cactode/k_type/PCB/K-Type PCBA BOM.xlsx

# | Qty | Part Reference | Part Number | MFGR | Description | Footprint | Notes
1 | 12 | C5,C8,C11,C20,C23,C12,C2,C6,C9,C16,C18,C21 | EMK105B7104KV-F | Taiyo Yuden | Multilayer Ceramic Capacitors MLCC - SMD/SMT .1uF 16Volts X7R +/-10% 0402 STD | SMD-0402
2 | 8 | C1,C3,C7,C10,C15,C17,C19,C22 | JMK105BJ474KV-F | Taiyo Yuden | Multilayer Ceramic Capacitors MLCC - SMD/SMT 0.47uF 6.3V X5R +/-10% 0402 Gen Purp | SMD-0402
3 | 1 | C4 | EEF-CX1D220R | Panasonic | Aluminum Organic Polymer Capacitors 22uF 20volt SP-Cap AEC-Q200 | SMD-7343-Pol | EEF-CS1D220R, EEF-CS1C220R (in that order) may be substituted.
4 | 2 | C14,C13 | JMK105C6225MV-F | Taiyo Yuden | Multilayer Ceramic Capacitors MLCC - SMD/SMT 2.2uF 6.3Volts X6S +/-20% 0402 STD | SMD-0402
5 | 87 | D1..D87 | 1N4148X-TP | MCC | Diodes - General Purpose, Power, Switching 150mA 75V | SOD-523
6 | 2 | J2,J1 | DX07B024XJ1R1300 | JAE Electronics | USB Connectors HYBRID SMT/THRU-HOLE MID MNT - USB TYPE C | USB_C_MIDMOUNT_TH_IMPCUT
7 | 87 | LED1..LED87 | KAILH-PG1280-SMT-LED | Kaihua or Hanhua | RGB LED - Reverse Mount | LED_RGB_3.2x2.8_REVMOUNT | This line item should be placed on the back, with the LED facing the FRONT. Common anode is marked on silk screen with 'A'.
8 | 32 | LED88..LED119 | KAILH-PG1280-SMT-LED | Kaihua or Hanhua | RGB LED - Reverse Mount | LED_RGB_3.2x2.8_REVMOUNT_BACKWARDS | This line item should be placed on the back, with the LED facing the BACK. Common anode is marked on silk screen with 'A'.
9 | 1 | LED120 | LO Q976-PS-25 | Osram | Standard LEDs - SMD Orange, 605nm 280mcd, 20mA | LED-0603
10 | 2 | R9,R17 | RK73B1ETTP133J | KOA Speer | Thick Film Resistors - SMD 1/16watts 13Kohms 5% | SMD-0402
11 | 4 | R8,R11,R7,R10 | RK73B1ETTP512J | KOA Speer | Thick Film Resistors - SMD 1/16watt 5.1Kohms 5% | SMD-0402
12 | 2 | R14,R15 | RK73B1ETTP101J | KOA Speer | Thick Film Resistors - SMD 1/16watts 100ohms 5% | SMD-0402
13 | 2 | R2,R1 | RK73B1ETTP330J | KOA Speer | Thick Film Resistors - SMD 1/16watts 33ohms 5% | SMD-0402
14 | 5 | R3,R4,R12,R13,R16 | RK73B1ETTP102J | KOA Speer | Thick Film Resistors - SMD 1/16watts 1Kohms 5% | SMD-0402
15 | 2 | R5,R6 | RK73B1ETTP104J | KOA Speer | Thick Film Resistors - SMD 1/16watt 100Kohms 5% | SMD-0402
16 | 87 | S1..S87 | CPG151101S11 | Kaihua | Switch Socket - SMD | SW_SOCKET_COMBINED | .pos file does not have coordinates for this component
17 | 1 | S88 | SKQGAKE010 | ALPS | Tactile Switches 50 mAmps at 12 Volts | TACT_5.2x5.2
18 | 1 | U1 | MK20DX256VLH7 | NXP / Freescale | ARM Microcontrollers - MCU KINETIS 256K | LQFP64
19 | 1 | U2 | TS3DS10224RUKR | Texas Instruments | Multiplexer Switch ICs High-Speed 2:4 Diff Mux/Demux | QFN_20_0.4
20 | 1 | U3 | TS3USB30EDGSR | Texas Instruments | USB Switch ICs High-Speed USB 2.0 1:2 Mux/Demux Switch | VSSOP-10
21 | 2 | U4,U5 | IS31FL3733 | ISSI | 12x16 DOTS MATRIX LED DRIVER, QFN-48 | QFN-48-1EP-6mm
22 | 1 | X1 | NX3225SA-16.000M-STD-CSR-1 | NDK | CRYSTAL 16.0000MHZ 8PF SMD | DFN_3.2x2.5 | CX3225GB16000D0HPQCC or NX3225SA-16.000M-STD-CSR-3 can be substituted.
