cactode/k_type/CAD/k-type-assembly.SLDASM

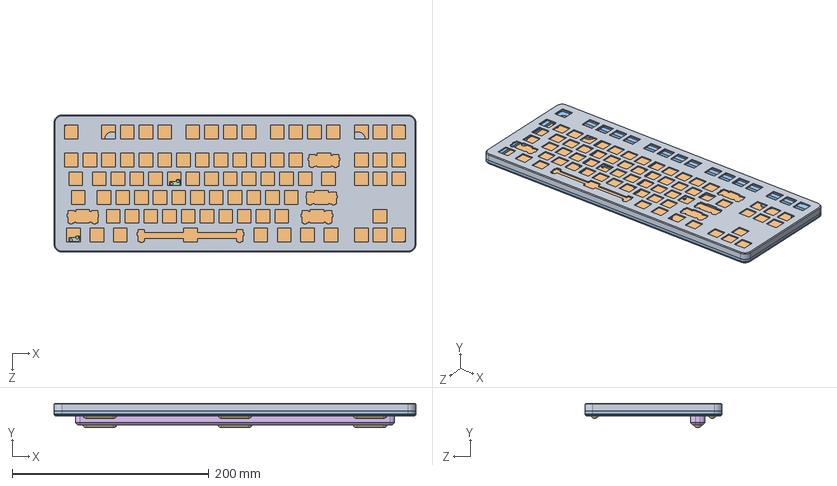
[picture p1: CAD file, 2019-05-21]
CAD/k-type-assembly.SLDASM
368.3 x 24.9 x 139.5 mm
k-type-case-billet
k-type-acrylic-spacer_nothing-special
Kailh-hot-swap-pcb x 2
reverse-mount-led x 2
k-type-bar-foot
pill-rubber-feet x 9
flat-head-shoulder-screw x 8
Metal-Disk-For-Magnetic-Feet x 2
8mm-neodymium-magnet x 2
