cactode/k_type/CAD/k-type-case-.SLDPRT

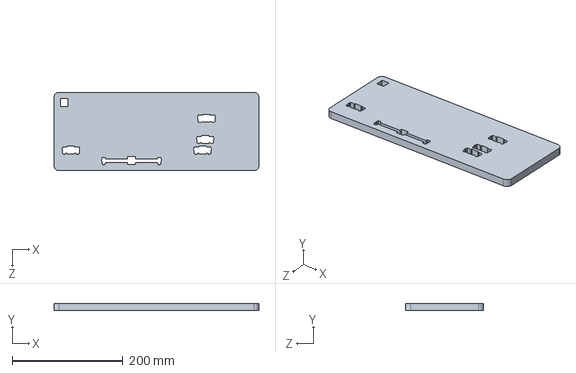
[picture p2: CAD file, 2019-06-02]
CAD/k-type-case-.SLDPRT
370.3 x 12.7 x 141.5 mm
