cactode/k_type/CAM/SACRIFICIAL_BLOCK.DXF

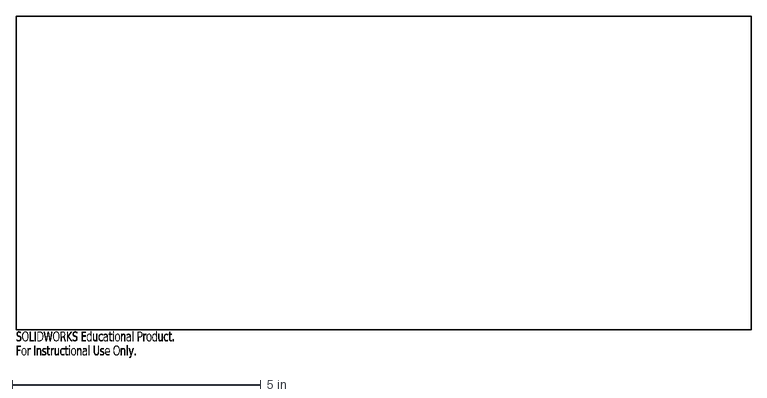
[picture p3: CAD file, 2019-06-02]
CAM/SACRIFICIAL_BLOCK.DXF
SOLIDWORKS Educational Product.
For Instructional Use Only.
