cactode/k_type/CAM/k-type-case-.DXF

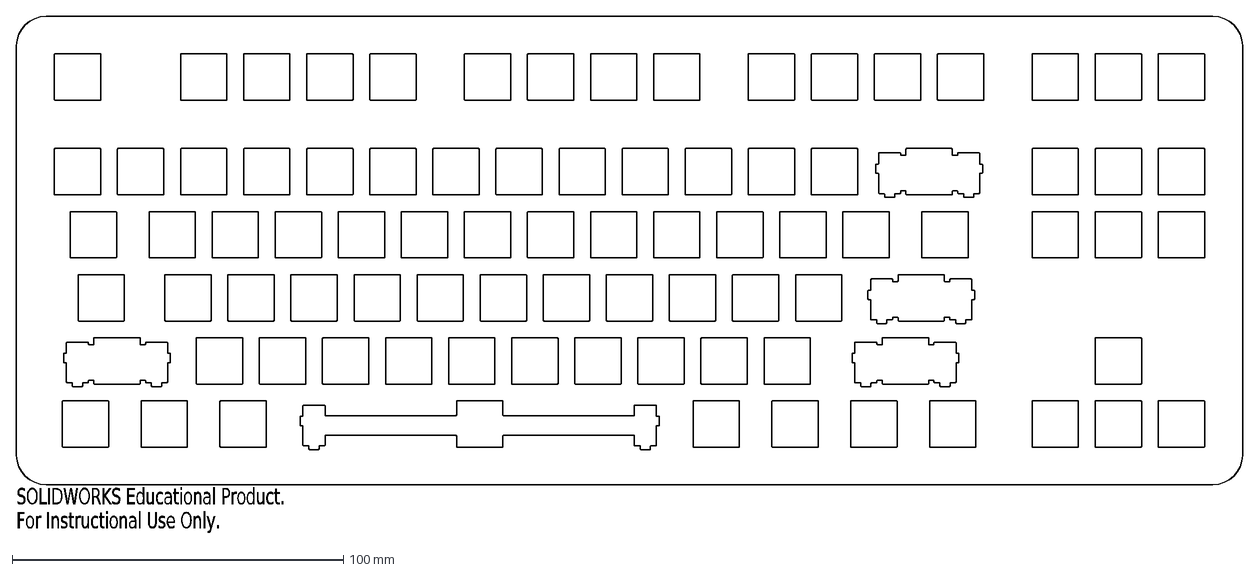
[picture p4: CAD file, 2019-06-02]
CAM/k-type-case-.DXF
SOLIDWORKS Educational Product.
For Instructional Use Only.
