cactode/k_type/CAD/STENCIL_STENCIL.DXF

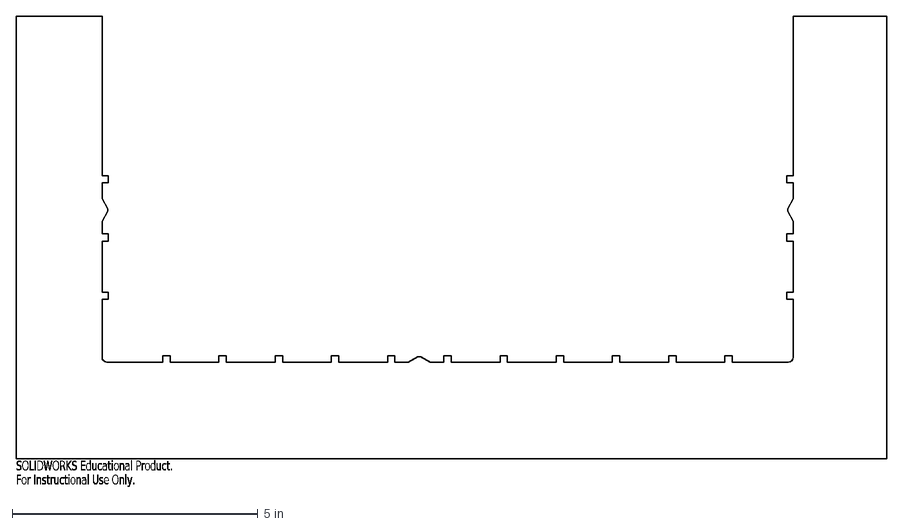
[picture p5: CAD file, 2019-05-21]
CAD/STENCIL_STENCIL.DXF
SOLIDWORKS Educational Product.
For Instructional Use Only.
