cactode/k_type/CAM/k-type-case-new_attempt.DXF

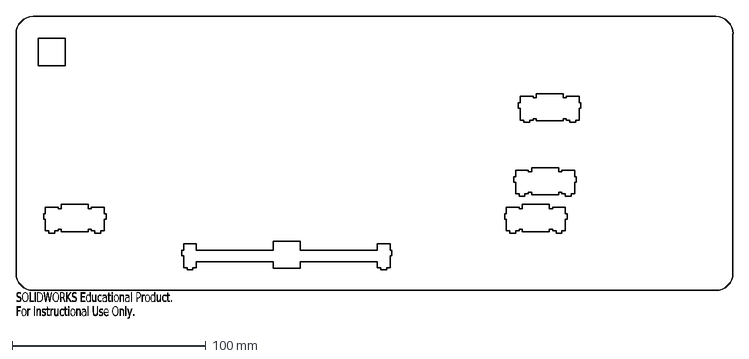
[picture p6: CAD file, 2019-06-02]
CAM/k-type-case-new_attempt.DXF
SOLIDWORKS Educational Product.
For Instructional Use Only.
