cactode/k_type/CAD/ktype-bottom-plate-alt.sldprt

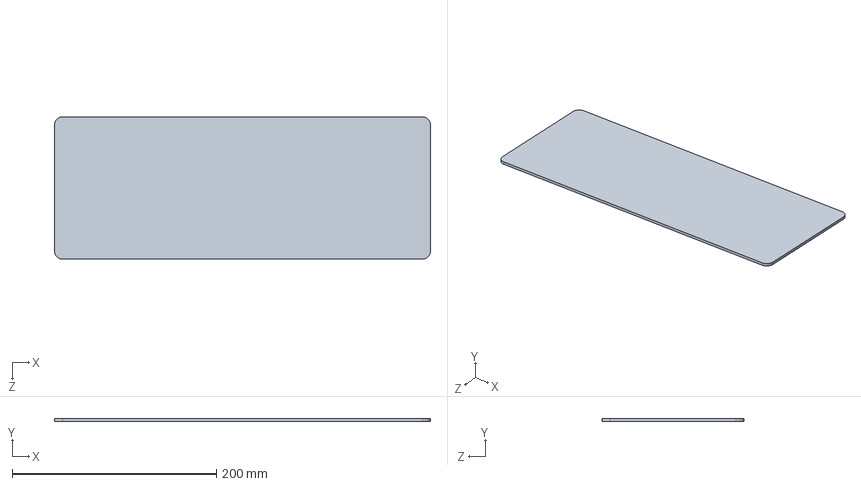
[picture p7: CAD file, 2019-05-21]
CAD/ktype-bottom-plate-alt.sldprt
368.3 x 3.00 x 139.5 mm
