cactode/k_type/CAD/ktype-bottom-plate.sldprt

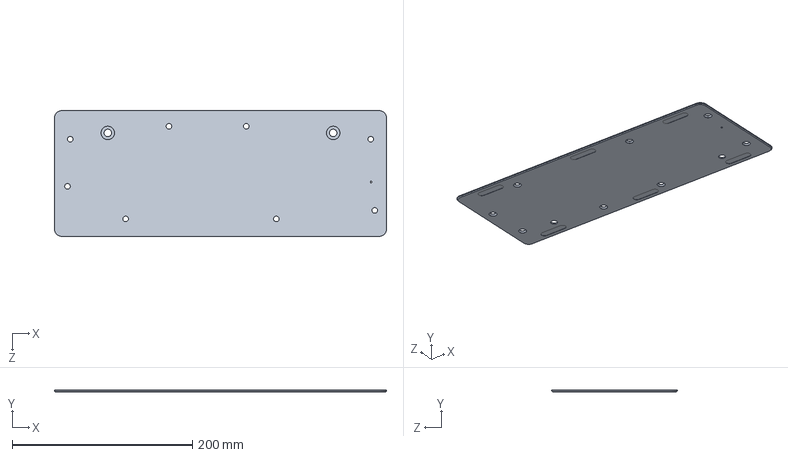
[picture p8: CAD file, 2019-05-21]
CAD/ktype-bottom-plate.sldprt
368.3 x 2.00 x 139.5 mm
