cactode/k_type/CAD/Pcb_1.sldprt

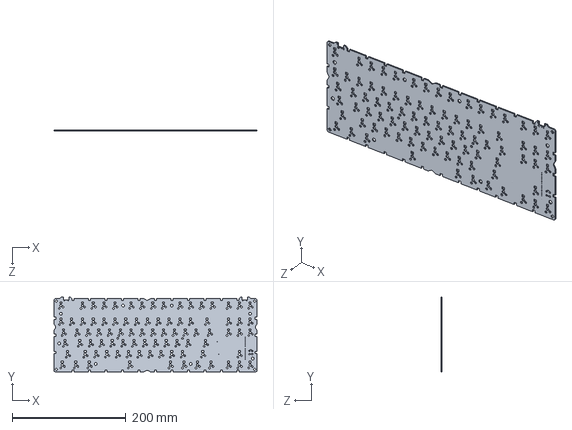
[picture p9: CAD file, 2019-05-21]
CAD/Pcb_1.sldprt
357.5 x 131.8 x 1.60 mm
