cactode/k_type/CAD/flat-head-shoulder-screw.sldprt

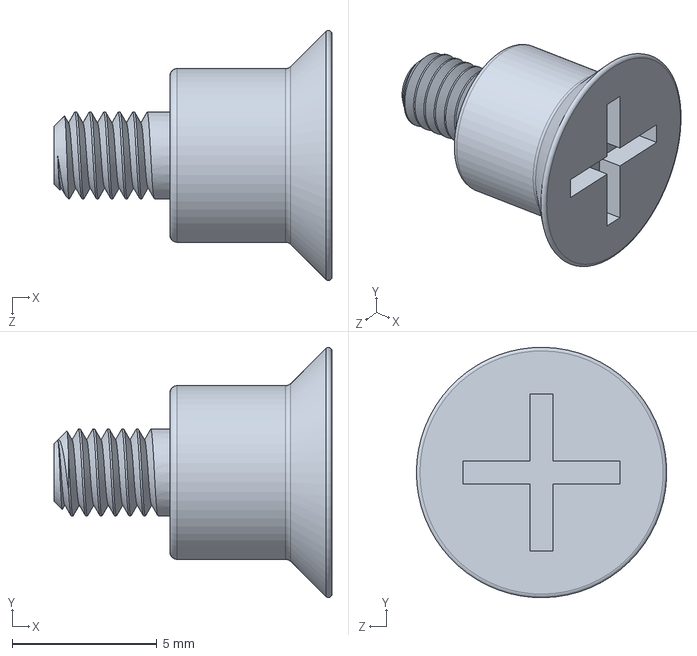
[picture p10: CAD file, 2019-05-21]
CAD/flat-head-shoulder-screw.sldprt
9.60 x 8.64 x 8.64 mm
