cactode/k_type/(list of files, cad)

Other CAD files:
CAD/8mm-neodymium-magnet.sldprt
CAD/Metal-Disk-For-Magnetic-Feet.sldprt
CAD/Kailh-hot-swap-pcb.sldprt
CAD/pill-rubber-feet.sldprt
CAD/k-type-acrylic-spacer_nothing-special.sldprt
CAD/k-type-bar-foot.sldprt
CAD/reverse-mount-led.sldprt
