cactode/k_type/PCB/K-Type.kicad_pcb

## KiCad design PCB/K-Type.kicad_pcb (2019-06-02)

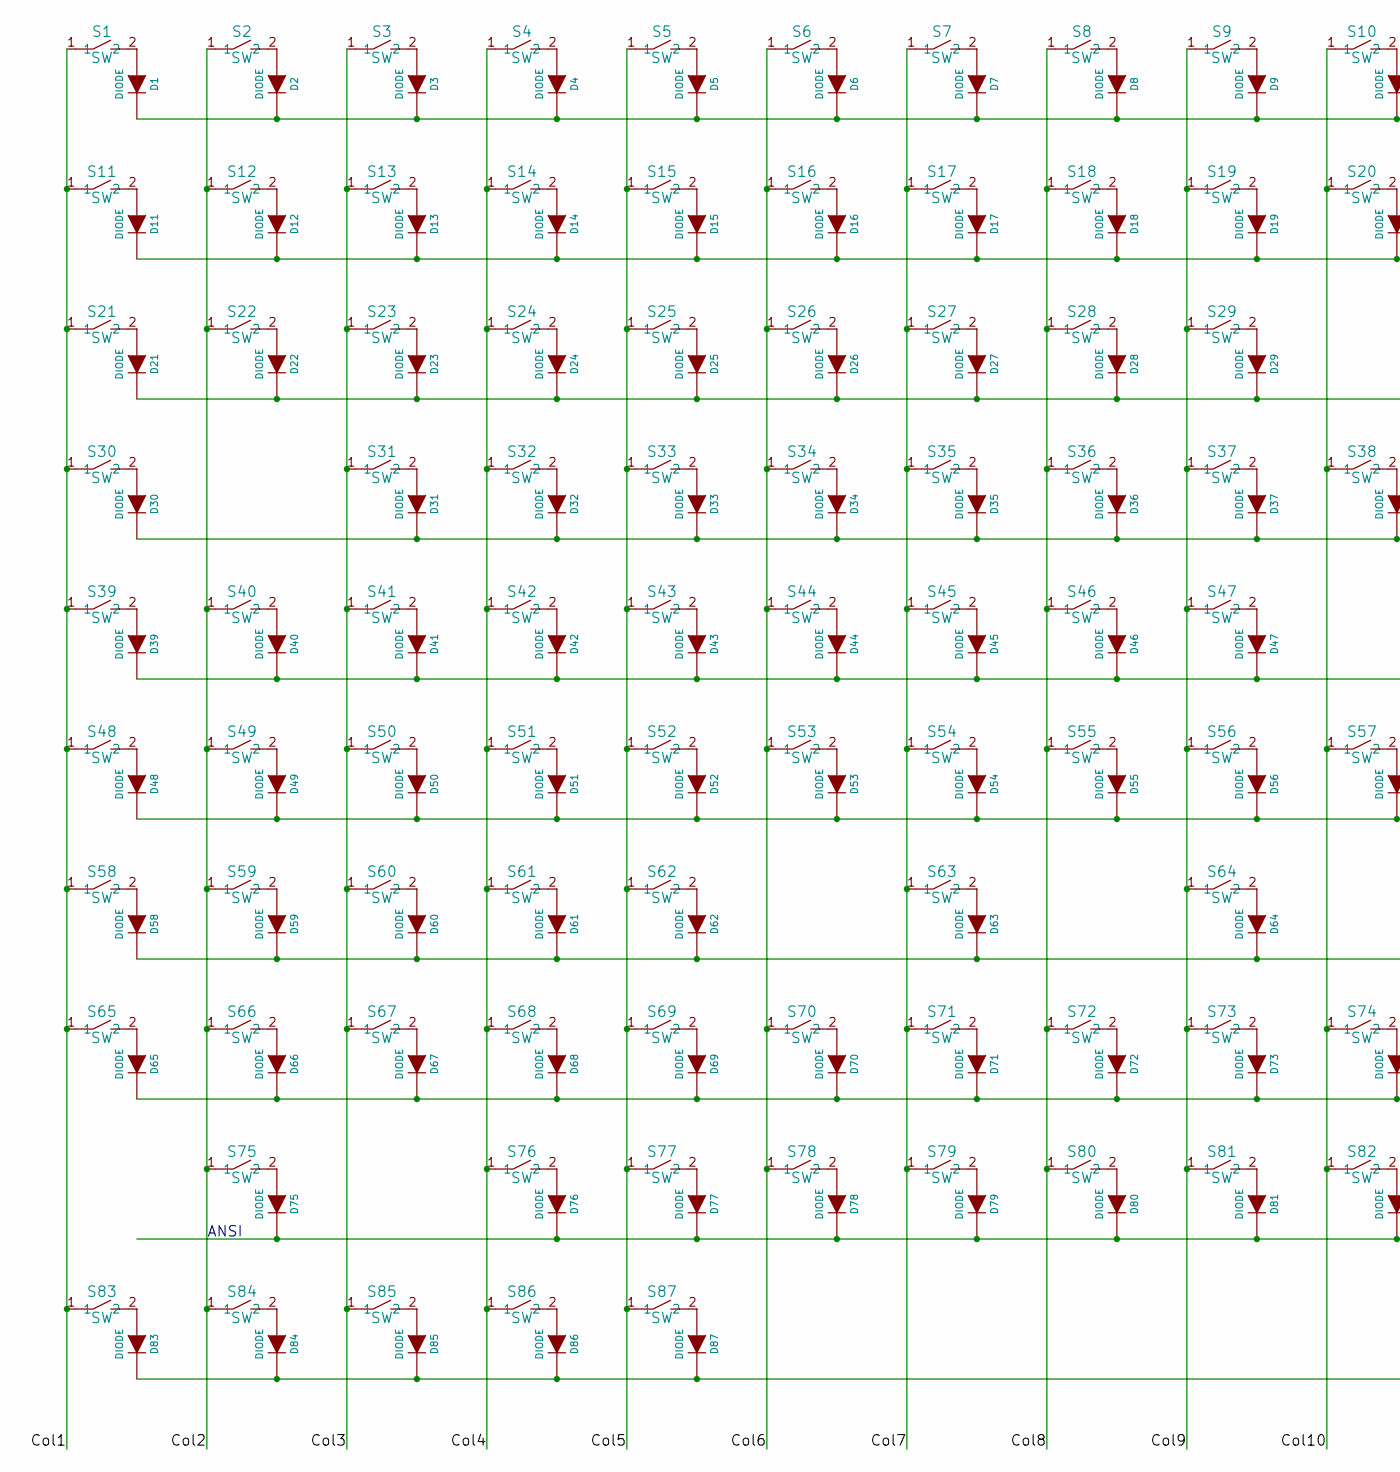
[picture p11: schematic K-Type.sch, part in row 1, column 1]

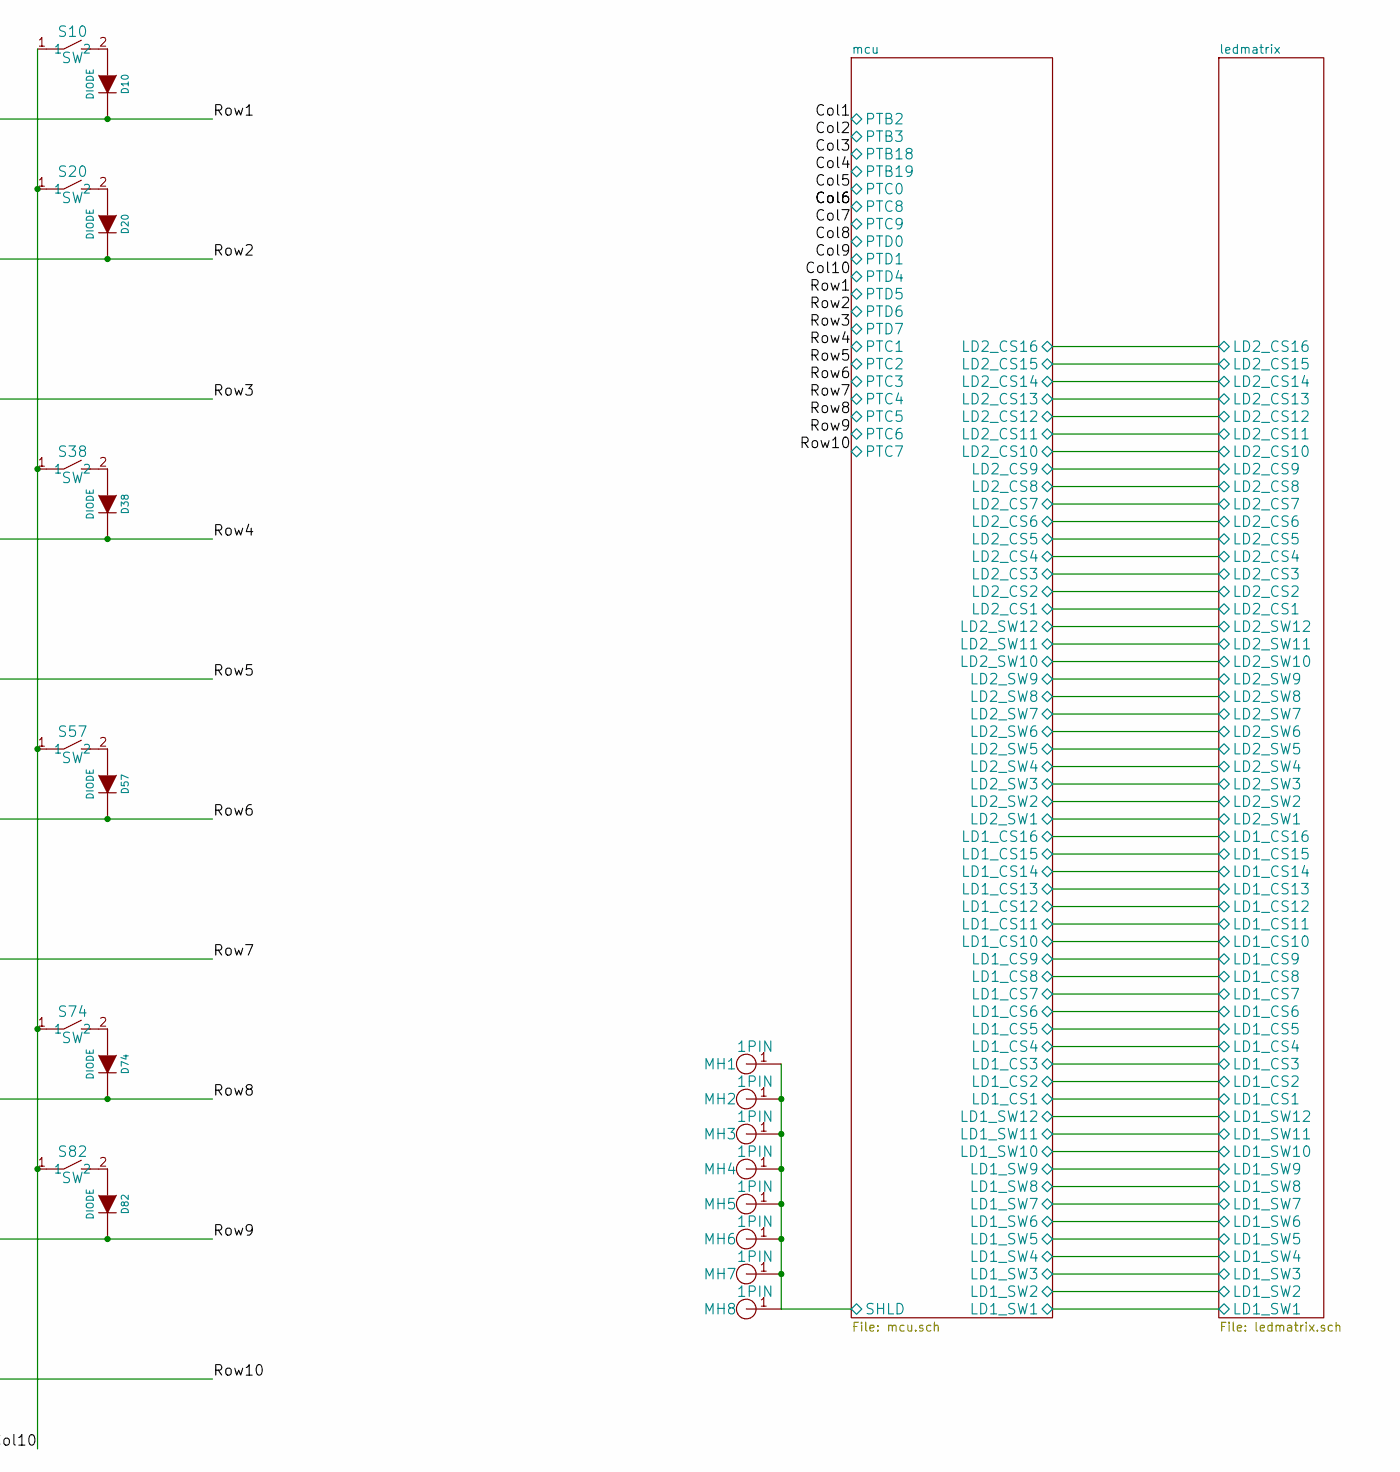
[picture p12: schematic K-Type.sch, part in row 1, column 2]

Parts:
D1, D2, D3, D4, D5, D6, D7, D8, D9, D10, D11, D12, D13, D14, D15, D16, D17, D18, D19, D20, D21, D22, D23, D24, D25, D26, D27, D28, D29, D30, D31, D32, D33, D34, D35, D36, D37, D38, D39, D40, D41, D42, D43, D44, D45, D46, D47, D48, D49, D50, D51, D52, D53, D54, D55, D56, D57, D58, D59, D60, D61, D62, D63, D64, D65, D66, D67, D68, D69, D70, D71, D72, D73, D74, D75, D76, D77, D78, D79, D80, D81, D82, D83, D84, D85, D86, D87: DIODE; SOD-523
MH1, MH2, MH3, MH4, MH5, MH6, MH7, MH8: 1PIN; 1PAD
S1, S2, S3, S4, S5, S6, S7, S8, S9, S10, S11, S12, S13, S14, S15, S16, S17, S18, S19, S20, S21, S22, S23, S24, S25, S26, S27, S28, S29, S30, S31, S32, S33, S34, S35, S36, S37, S38, S39, S40, S41, S42, S43, S44, S45, S46, S47, S48, S49, S50, S51, S52, S53, S54, S55, S56, S57, S58, S59, S60, S61, S62, S63, S64, S65, S66, S67, S68, S69, S70, S71, S72, S73, S74, S75, S76, S77, S78, S79, S80, S81, S82, S83, S84, S85, S86, S87: SW; SW_SOCKET_COMBINED_T

Connections:
/Col1: S1.1, S11.1, S21.1, S30.1, S39.1, S48.1, S58.1, S65.1, S83.1; also elsewhere on the board
/Col2: S2.1, S12.1, S22.1, S40.1, S49.1, S59.1, S66.1, S75.1, S84.1; also elsewhere on the board
/Col3: S3.1, S13.1, S23.1, S31.1, S41.1, S50.1, S60.1, S67.1, S85.1; also elsewhere on the board
/Col4: S4.1, S14.1, S24.1, S32.1, S42.1, S51.1, S61.1, S68.1, S76.1, S86.1; also elsewhere on the board
/Col5: S5.1, S15.1, S25.1, S33.1, S43.1, S52.1, S62.1, S69.1, S77.1, S87.1; also elsewhere on the board
/Col6: S6.1, S16.1, S26.1, S34.1, S44.1, S53.1, S70.1, S78.1; also elsewhere on the board
/Col7: S7.1, S17.1, S27.1, S35.1, S45.1, S54.1, S63.1, S71.1, S79.1; also elsewhere on the board
/Col8: S8.1, S18.1, S28.1, S36.1, S46.1, S55.1, S72.1, S80.1; also elsewhere on the board
/Col9: S9.1, S19.1, S29.1, S37.1, S47.1, S56.1, S64.1, S73.1, S81.1; also elsewhere on the board
/Col10: S10.1, S20.1, S38.1, S57.1, S74.1, S82.1; also elsewhere on the board
/Row1: D1.2 (K), D2.2 (K), D3.2 (K), D4.2 (K), D5.2 (K), D6.2 (K), D7.2 (K), D8.2 (K), D9.2 (K), D10.2 (K); also elsewhere on the board
/Row2: D11.2 (K), D12.2 (K), D13.2 (K), D14.2 (K), D15.2 (K), D16.2 (K), D17.2 (K), D18.2 (K), D19.2 (K), D20.2 (K); also elsewhere on the board
/Row3: D21.2 (K), D22.2 (K), D23.2 (K), D24.2 (K), D25.2 (K), D26.2 (K), D27.2 (K), D28.2 (K), D29.2 (K); also elsewhere on the board
/Row4: D30.2 (K), D31.2 (K), D32.2 (K), D33.2 (K), D34.2 (K), D35.2 (K), D36.2 (K), D37.2 (K), D38.2 (K); also elsewhere on the board
/Row5: D39.2 (K), D40.2 (K), D41.2 (K), D42.2 (K), D43.2 (K), D44.2 (K), D45.2 (K), D46.2 (K), D47.2 (K); also elsewhere on the board
/Row6: D48.2 (K), D49.2 (K), D50.2 (K), D51.2 (K), D52.2 (K), D53.2 (K), D54.2 (K), D55.2 (K), D56.2 (K), D57.2 (K); also elsewhere on the board
/Row7: D58.2 (K), D59.2 (K), D60.2 (K), D61.2 (K), D62.2 (K), D63.2 (K), D64.2 (K); also elsewhere on the board
/Row8: D65.2 (K), D66.2 (K), D67.2 (K), D68.2 (K), D69.2 (K), D70.2 (K), D71.2 (K), D72.2 (K), D73.2 (K), D74.2 (K); also elsewhere on the board
/Row9: D75.2 (K), D76.2 (K), D77.2 (K), D78.2 (K), D79.2 (K), D80.2 (K), D81.2 (K), D82.2 (K); also elsewhere on the board
/Row10: D83.2 (K), D84.2 (K), D85.2 (K), D86.2 (K), D87.2 (K); also elsewhere on the board
/mcu/SHLD: MH1.1, MH2.1, MH3.1, MH4.1, MH5.1, MH6.1, MH7.1, MH8.1; also elsewhere on the board
unnamed: D1.1 (A), S1.2
unnamed: D2.1 (A), S2.2
unnamed: D3.1 (A), S3.2
unnamed: D4.1 (A), S4.2
unnamed: D5.1 (A), S5.2
unnamed: D6.1 (A), S6.2
unnamed: D7.1 (A), S7.2
unnamed: D8.1 (A), S8.2
unnamed: D9.1 (A), S9.2
unnamed: D10.1 (A), S10.2
unnamed: D11.1 (A), S11.2
unnamed: D12.1 (A), S12.2
unnamed: D13.1 (A), S13.2
unnamed: D14.1 (A), S14.2
unnamed: D15.1 (A), S15.2
unnamed: D16.1 (A), S16.2
unnamed: D17.1 (A), S17.2
unnamed: D18.1 (A), S18.2
unnamed: D19.1 (A), S19.2
unnamed: D20.1 (A), S20.2
unnamed: D21.1 (A), S21.2
unnamed: D22.1 (A), S22.2
unnamed: D23.1 (A), S23.2
unnamed: D24.1 (A), S24.2
unnamed: D25.1 (A), S25.2
unnamed: D26.1 (A), S26.2
unnamed: D27.1 (A), S27.2
unnamed: D28.1 (A), S28.2
unnamed: D29.1 (A), S29.2
unnamed: D30.1 (A), S30.2
unnamed: D31.1 (A), S31.2
unnamed: D32.1 (A), S32.2
unnamed: D33.1 (A), S33.2
unnamed: D34.1 (A), S34.2
unnamed: D35.1 (A), S35.2
unnamed: D36.1 (A), S36.2
unnamed: D37.1 (A), S37.2
unnamed: D38.1 (A), S38.2
unnamed: D39.1 (A), S39.2
unnamed: D40.1 (A), S40.2
unnamed: D41.1 (A), S41.2
unnamed: D42.1 (A), S42.2
unnamed: D43.1 (A), S43.2
unnamed: D44.1 (A), S44.2
unnamed: D45.1 (A), S45.2
unnamed: D46.1 (A), S46.2
unnamed: D47.1 (A), S47.2
unnamed: D48.1 (A), S48.2
unnamed: D49.1 (A), S49.2
unnamed: D50.1 (A), S50.2
unnamed: D51.1 (A), S51.2
unnamed: D52.1 (A), S52.2
unnamed: D53.1 (A), S53.2
unnamed: D54.1 (A), S54.2
unnamed: D55.1 (A), S55.2
unnamed: D56.1 (A), S56.2
unnamed: D57.1 (A), S57.2
unnamed: D58.1 (A), S58.2
unnamed: D59.1 (A), S59.2
unnamed: D60.1 (A), S60.2
unnamed: D61.1 (A), S61.2
unnamed: D62.1 (A), S62.2
unnamed: D63.1 (A), S63.2
unnamed: D64.1 (A), S64.2
unnamed: D65.1 (A), S65.2
unnamed: D66.1 (A), S66.2
unnamed: D67.1 (A), S67.2
unnamed: D68.1 (A), S68.2
unnamed: D69.1 (A), S69.2
unnamed: D70.1 (A), S70.2
unnamed: D71.1 (A), S71.2
unnamed: D72.1 (A), S72.2
unnamed: D73.1 (A), S73.2
unnamed: D74.1 (A), S74.2
unnamed: D75.1 (A), S75.2
unnamed: D76.1 (A), S76.2
unnamed: D77.1 (A), S77.2
unnamed: D78.1 (A), S78.2
unnamed: D79.1 (A), S79.2
unnamed: D80.1 (A), S80.2
unnamed: D81.1 (A), S81.2
unnamed: D82.1 (A), S82.2
unnamed: D83.1 (A), S83.2
unnamed: D84.1 (A), S84.2
unnamed: D85.1 (A), S85.2
unnamed: D86.1 (A), S86.2
unnamed: D87.1 (A), S87.2

Notes on the sheet:
ANSI

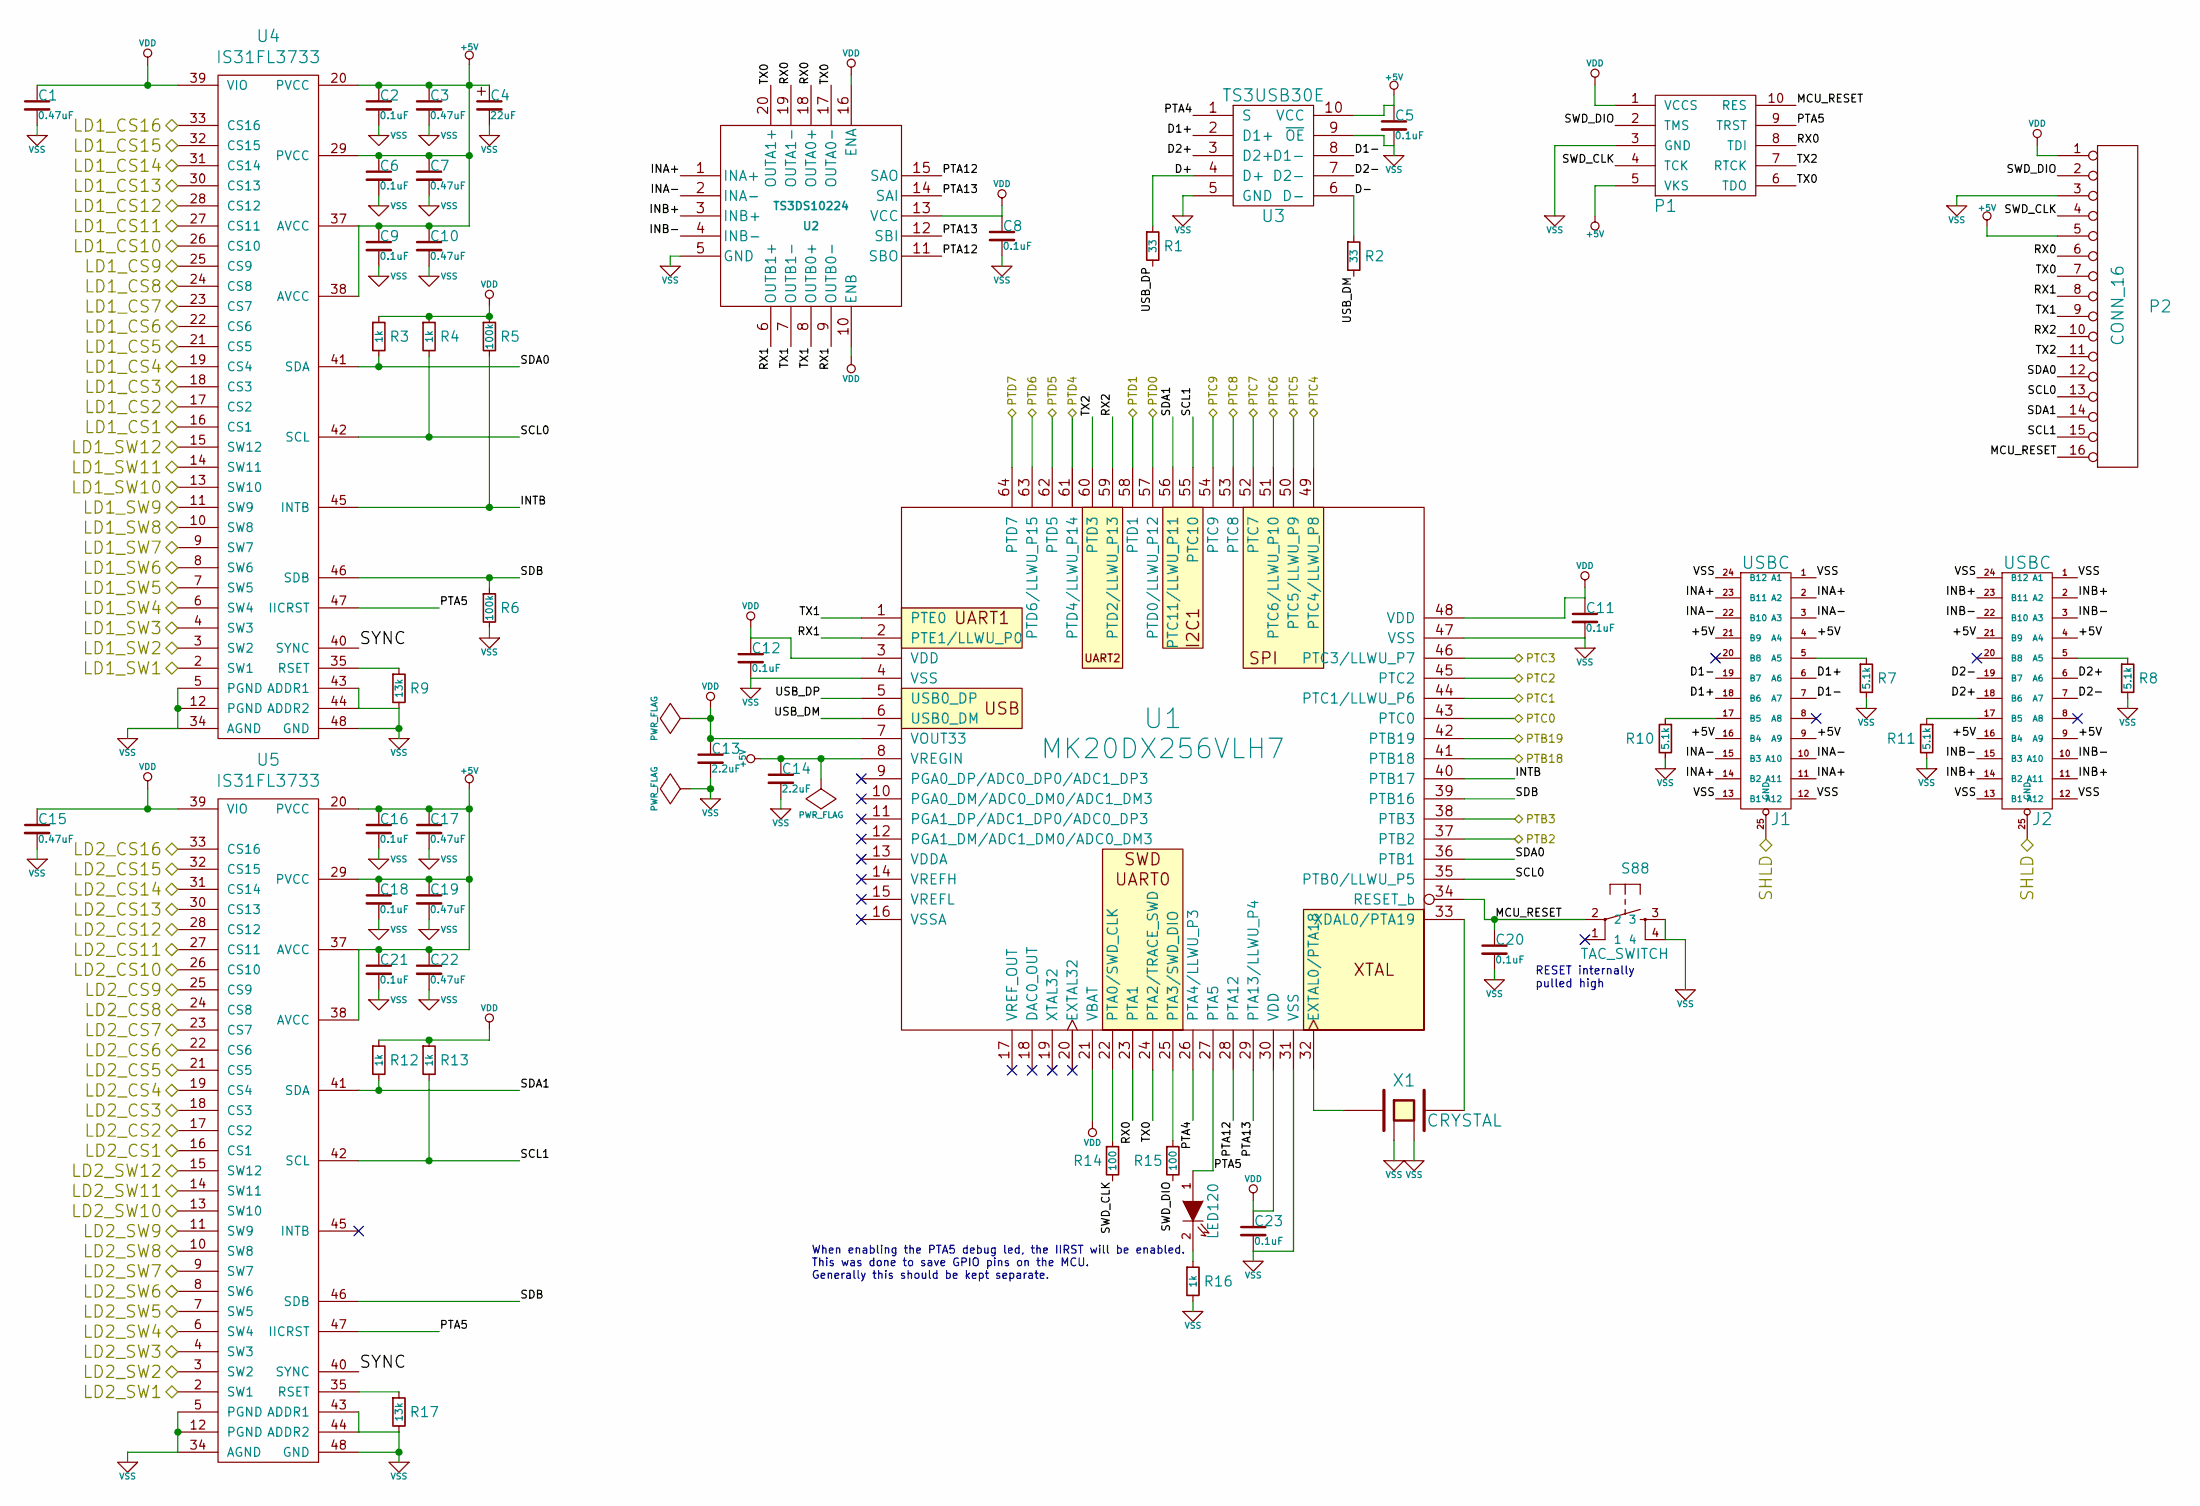
[picture p13: schematic mcu.sch, K-Type]

Parts:
C1, C3, C7, C10, C15, C17, C19, C22: 0.47uF; SMD-0402
C2, C5, C6, C8, C9, C11, C12, C16, C18, C20, C21, C23: 0.1uF; SMD-0402
C4: 22uF; SMD-7343-Pol
C13, C14: 2.2uF; SMD-0402
J1, J2: USBC; USB_C_MIDMOUNT_TH_IMPCUT
LED120: LED; LED-0603
P1: FLASH_HDR; JLINK_NEEDLE
P2: CONN_16; HEADER_1x16
R1, R2: 33; SMD-0402
R3, R4, R12, R13, R16: 1k; SMD-0402
R5, R6: 100k; SMD-0402
R7, R8, R10, R11: 5.1k; SMD-0402
R9, R17: 13k; SMD-0402
R14, R15: 100; SMD-0402
S88: TAC_SWITCH; TACT_5.2x5.2
U1: MK20DX256VLH7; LQFP64
U2: TS3DS10224; QFN_20_0.4
U3: TS3USB30E; VSSOP-10
U4, U5: IS31FL3733; QFN-48-6mm-vias
X1: CRYSTAL; NX3225SA

Connections:
+5V: C2.1, C3.1, C4.1, C5.1, C6.1, C7.1, C9.1, C10.1, C14.1, C16.1, C17.1, C18.1, C19.1, C21.1, C22.1, J1.4 (A4), J1.9 (A9), J1.16 (B4), J1.21 (B9), J2.4 (A4), J2.9 (A9), J2.16 (B4), J2.21 (B9), P1.5 (VKS), P2.5, U1.8 (VREGIN), U3.10 (VCC), U4.20 (PVCC), U4.29 (PVCC), U4.37 (AVCC), U4.38 (AVCC), U5.20 (PVCC), U5.29 (PVCC), U5.37 (AVCC), U5.38 (AVCC)
/Col1: U1.37 (PTB2); also elsewhere on the board
/Col2: U1.38 (PTB3); also elsewhere on the board
/Col3: U1.41 (PTB18); also elsewhere on the board
/Col4: U1.42 (PTB19); also elsewhere on the board
/Col5: U1.43 (PTC0); also elsewhere on the board
/Col6: U1.53 (PTC8); also elsewhere on the board
/Col7: U1.54 (PTC9); also elsewhere on the board
/Col8: U1.57 (PTD0/LLWU_P12); also elsewhere on the board
/Col9: U1.58 (PTD1); also elsewhere on the board
/Col10: U1.61 (PTD4/LLWU_P14); also elsewhere on the board
/Row1: U1.62 (PTD5); also elsewhere on the board
/Row2: U1.63 (PTD6/LLWU_P15); also elsewhere on the board
/Row3: U1.64 (PTD7); also elsewhere on the board
/Row4: U1.44 (PTC1/LLWU_P6); also elsewhere on the board
/Row5: U1.45 (PTC2); also elsewhere on the board
/Row6: U1.46 (PTC3/LLWU_P7); also elsewhere on the board
/Row7: U1.49 (PTC4/LLWU_P8); also elsewhere on the board
/Row8: U1.50 (PTC5/LLWU_P9); also elsewhere on the board
/Row9: U1.51 (PTC6/LLWU_P10); also elsewhere on the board
/Row10: U1.52 (PTC7); also elsewhere on the board
/ledmatrix/LD1_CS1: U4.16 (CS1); also elsewhere on the board
/ledmatrix/LD1_CS2: U4.17 (CS2); also elsewhere on the board
/ledmatrix/LD1_CS3: U4.18 (CS3); also elsewhere on the board
/ledmatrix/LD1_CS4: U4.19 (CS4); also elsewhere on the board
/ledmatrix/LD1_CS5: U4.21 (CS5); also elsewhere on the board
/ledmatrix/LD1_CS6: U4.22 (CS6); also elsewhere on the board
/ledmatrix/LD1_CS7: U4.23 (CS7); also elsewhere on the board
/ledmatrix/LD1_CS8: U4.24 (CS8); also elsewhere on the board
/ledmatrix/LD1_CS9: U4.25 (CS9); also elsewhere on the board
/ledmatrix/LD1_CS10: U4.26 (CS10); also elsewhere on the board
/ledmatrix/LD1_CS11: U4.27 (CS11); also elsewhere on the board
/ledmatrix/LD1_CS12: U4.28 (CS12); also elsewhere on the board
/ledmatrix/LD1_CS13: U4.30 (CS13); also elsewhere on the board
/ledmatrix/LD1_CS14: U4.31 (CS14); also elsewhere on the board
/ledmatrix/LD1_CS15: U4.32 (CS15); also elsewhere on the board
/ledmatrix/LD1_CS16: U4.33 (CS16); also elsewhere on the board
/ledmatrix/LD1_SW1: U4.2 (SW1); also elsewhere on the board
/ledmatrix/LD1_SW2: U4.3 (SW2); also elsewhere on the board
/ledmatrix/LD1_SW3: U4.4 (SW3); also elsewhere on the board
/ledmatrix/LD1_SW4: U4.6 (SW4); also elsewhere on the board
/ledmatrix/LD1_SW5: U4.7 (SW5); also elsewhere on the board
/ledmatrix/LD1_SW6: U4.8 (SW6); also elsewhere on the board
/ledmatrix/LD1_SW7: U4.9 (SW7); also elsewhere on the board
/ledmatrix/LD1_SW8: U4.10 (SW8); also elsewhere on the board
/ledmatrix/LD1_SW9: U4.11 (SW9); also elsewhere on the board
/ledmatrix/LD1_SW10: U4.13 (SW10); also elsewhere on the board
/ledmatrix/LD1_SW11: U4.14 (SW11); also elsewhere on the board
/ledmatrix/LD1_SW12: U4.15 (SW12); also elsewhere on the board
/ledmatrix/LD2_CS1: U5.16 (CS1); also elsewhere on the board
/ledmatrix/LD2_CS2: U5.17 (CS2); also elsewhere on the board
/ledmatrix/LD2_CS3: U5.18 (CS3); also elsewhere on the board
/ledmatrix/LD2_CS4: U5.19 (CS4); also elsewhere on the board
/ledmatrix/LD2_CS5: U5.21 (CS5); also elsewhere on the board
/ledmatrix/LD2_CS6: U5.22 (CS6); also elsewhere on the board
/ledmatrix/LD2_CS7: U5.23 (CS7); also elsewhere on the board
/ledmatrix/LD2_CS8: U5.24 (CS8); also elsewhere on the board
/ledmatrix/LD2_CS9: U5.25 (CS9); also elsewhere on the board
/ledmatrix/LD2_CS10: U5.26 (CS10); also elsewhere on the board
/ledmatrix/LD2_CS11: U5.27 (CS11); also elsewhere on the board
/ledmatrix/LD2_CS12: U5.28 (CS12); also elsewhere on the board
/ledmatrix/LD2_CS13: U5.30 (CS13); also elsewhere on the board
/ledmatrix/LD2_CS14: U5.31 (CS14); also elsewhere on the board
/ledmatrix/LD2_CS15: U5.32 (CS15); also elsewhere on the board
/ledmatrix/LD2_CS16: U5.33 (CS16); also elsewhere on the board
/ledmatrix/LD2_SW1: U5.2 (SW1); also elsewhere on the board
/ledmatrix/LD2_SW2: U5.3 (SW2); also elsewhere on the board
/ledmatrix/LD2_SW3: U5.4 (SW3); also elsewhere on the board
/ledmatrix/LD2_SW4: U5.6 (SW4); also elsewhere on the board
/ledmatrix/LD2_SW5: U5.7 (SW5); also elsewhere on the board
/ledmatrix/LD2_SW6: U5.8 (SW6); also elsewhere on the board
/ledmatrix/LD2_SW7: U5.9 (SW7); also elsewhere on the board
/ledmatrix/LD2_SW8: U5.10 (SW8); also elsewhere on the board
/ledmatrix/LD2_SW9: U5.11 (SW9); also elsewhere on the board
/ledmatrix/LD2_SW10: U5.13 (SW10); also elsewhere on the board
/ledmatrix/LD2_SW11: U5.14 (SW11); also elsewhere on the board
/ledmatrix/LD2_SW12: U5.15 (SW12); also elsewhere on the board
/mcu/D1+: J1.6 (A6), J1.18 (B6), U3.2 (D1+)
/mcu/D1-: J1.7 (A7), J1.19 (B7), U3.8 (D1-)
/mcu/D2+: J2.6 (A6), J2.18 (B6), U3.3 (D2+)
/mcu/D2-: J2.7 (A7), J2.19 (B7), U3.7 (D2-)
/mcu/D+: R1.1, U3.4 (D+)
/mcu/D-: R2.1, U3.6 (D-)
/mcu/INA+: J1.2 (A2), J1.11 (A11), J1.14 (B2), J1.23 (B11), U2.1 (INA+)
/mcu/INA-: J1.3 (A3), J1.10 (A10), J1.15 (B3), J1.22 (B10), U2.2 (INA-)
/mcu/INB+: J2.2 (A2), J2.11 (A11), J2.14 (B2), J2.23 (B11), U2.3 (INB+)
/mcu/INB-: J2.3 (A3), J2.10 (A10), J2.15 (B3), J2.22 (B10), U2.4 (INB-)
/mcu/INTB: R5.2, U1.40 (PTB17), U4.45 (INTB)
/mcu/MCU_RESET: C20.1, P1.10 (RES), P2.16, S88.2, U1.34 (RESET_b)
/mcu/PTA4: U1.26 (PTA4/LLWU_P3), U3.1 (S)
/mcu/PTA5: LED120.1 (A), P1.9 (TRST), U1.27 (PTA5), U4.47 (IICRST), U5.47 (IICRST)
/mcu/PTA12: U1.28 (PTA12), U2.11 (SBO), U2.15 (SAO)
/mcu/PTA13: U1.29 (PTA13/LLWU_P4), U2.12 (SBI), U2.14 (SAI)
/mcu/RX0: P1.8 (TDI), P2.6, U1.23 (PTA1), U2.18 (OUTA0+), U2.19 (OUTA1-)
/mcu/RX1: P2.8, U1.2 (PTE1/LLWU_P0), U2.6 (OUTB1+), U2.9 (OUTB0-)
/mcu/RX2: P2.10, U1.59 (PTD2/LLWU_P13)
/mcu/SCL0: P2.13, R4.2, U1.35 (PTB0/LLWU_P5), U4.42 (SCL)
/mcu/SCL1: P2.15, R13.2, U1.55 (PTC10), U5.42 (SCL)
/mcu/SDA0: P2.12, R3.2, U1.36 (PTB1), U4.41 (SDA)
/mcu/SDA1: P2.14, R12.2, U1.56 (PTC11/LLWU_P11), U5.41 (SDA)
/mcu/SDB: R6.1, U1.39 (PTB16), U4.46 (SDB), U5.46 (SDB)
/mcu/SHLD: J1.25 (GND), J2.25 (GND); also elsewhere on the board
/mcu/SWD_CLK: P1.4 (TCK), P2.4, R14.2
/mcu/SWD_DIO: P1.2 (TMS), P2.2, R15.2
/mcu/SYNC: U4.40 (SYNC), U5.40 (SYNC)
/mcu/TX0: P1.6 (TDO), P2.7, U1.24 (PTA2/TRACE_SWD), U2.17 (OUTA0-), U2.20 (OUTA1+)
/mcu/TX1: P2.9, U1.1 (PTE0), U2.7 (OUTB1-), U2.8 (OUTB0+)
/mcu/TX2: P1.7 (RTCK), P2.11, U1.60 (PTD3)
/mcu/USB_DM: R2.2, U1.6 (USB0_DM)
/mcu/USB_DP: R1.2, U1.5 (USB0_DP)
unnamed: J1.5 (A5), R7.1
unnamed: J1.17 (B5), R10.1
unnamed: J2.5 (A5), R8.1
unnamed: J2.17 (B5), R11.1
unnamed: LED120.2 (K), R16.1
unnamed: R9.1, U4.35 (RSET)
unnamed: R14.1, U1.22 (PTA0/SWD_CLK)
unnamed: R15.1, U1.25 (PTA3/SWD_DIO)
unnamed: R17.1, U5.35 (RSET)
unnamed: U1.32 (EXTAL0/PTA18), X1.1
unnamed: U1.33 (XDAL0/PTA19), X1.3
VDD: C1.1, C8.1, C11.1, C12.1, C13.1, C15.1, C23.1, P1.1 (VCCS), P2.1, R3.1, R4.1, R5.1, R12.1, R13.1, U1.3 (VDD), U1.7 (VOUT33), U1.21 (VBAT), U1.30 (VDD), U1.48 (VDD), U2.10 (ENB), U2.13 (VCC), U2.16 (ENA), U4.39 (VIO), U5.39 (VIO)
VSS: C1.2, C2.2, C3.2, C4.2, C5.2, C6.2, C7.2, C8.2, C9.2, C10.2, C11.2, C12.2, C13.2, C14.2, C15.2, C16.2, C17.2, C18.2, C19.2, C20.2, C21.2, C22.2, C23.2, J1.1 (A1), J1.12 (A12), J1.13 (B1), J1.24 (B12), J2.1 (A1), J2.12 (A12), J2.13 (B1), J2.24 (B12), P1.3 (GND), P2.3, R6.2, R7.2, R8.2, R9.2, R10.2, R11.2, R16.2, R17.2, S88.3, S88.4, U1.4 (VSS), U1.31 (VSS), U1.47 (VSS), U2.5 (GND), U3.5 (GND), U3.9 (~OE), U4.5 (PGND), U4.12 (PGND), U4.34 (AGND), U4.43 (ADDR1), U4.44 (ADDR2), U4.48 (GND), U5.5 (PGND), U5.12 (PGND), U5.34 (AGND), U5.43 (ADDR1), U5.44 (ADDR2), U5.48 (GND), X1.2, X1.4

Notes on the sheet:
RESET internally pulled high
When enabling the PTA5 debug led, the IIRST will be enabled. This was done to save GPIO pins on the MCU. Generally this should be kept separate.
