cactode/k_type/PCB/K-Type.kicad_pcb

## KiCad design PCB/K-Type.kicad_pcb (continued)

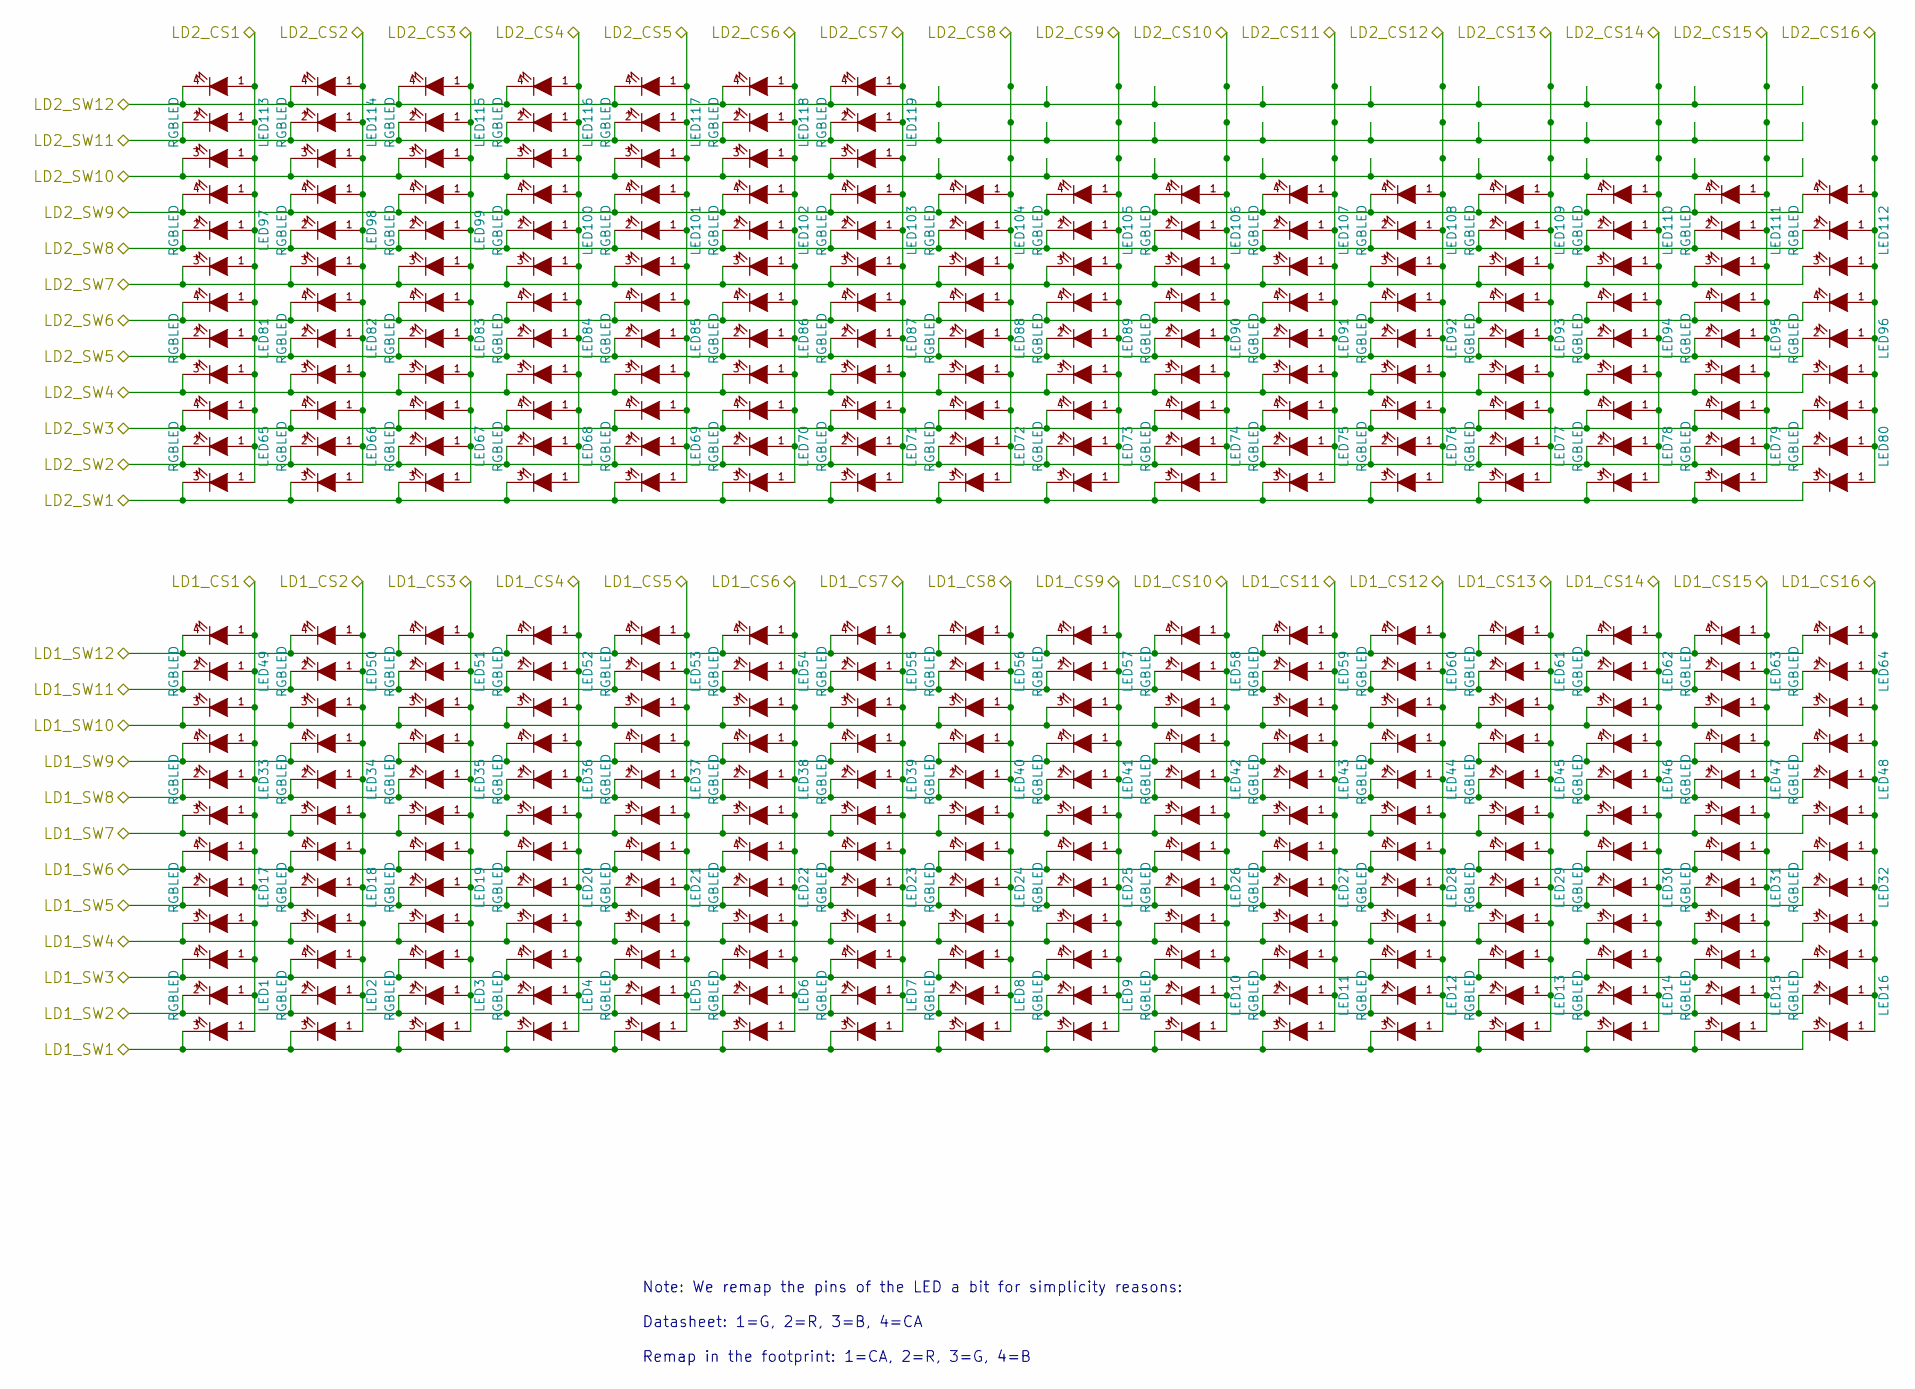
[picture p14: schematic ledmatrix.sch, K-Type]

Parts:
LED1, LED2, LED3, LED4, LED5, LED6, LED7, LED8, LED9, LED10, LED11, LED12, LED13, LED14, LED15, LED16, LED17, LED18, LED19, LED20, LED21, LED22, LED23, LED24, LED25, LED26, LED27, LED28, LED29, LED30, LED31, LED32, LED33, LED34, LED35, LED36, LED37, LED38, LED39, LED40, LED41, LED42, LED43, LED44, LED45, LED46, LED47, LED48, LED49, LED50, LED51, LED52, LED53, LED54, LED55, LED56, LED57, LED58, LED59, LED60, LED61, LED62, LED63, LED64, LED65, LED66, LED67, LED68, LED69, LED70, LED71, LED72, LED73, LED74, LED75, LED76, LED77, LED78, LED79, LED80, LED81, LED82, LED83, LED84, LED85, LED86, LED87: RGBLED; LED_RGB_3.2x2.8_REVMOUNT
LED88, LED89, LED90, LED91, LED92, LED93, LED94, LED95, LED96, LED97, LED98, LED99, LED100, LED101, LED102, LED103, LED104, LED105, LED106, LED107, LED108, LED109, LED110, LED111, LED112, LED113, LED114, LED115, LED116, LED117, LED118, LED119: RGBLED; LED_RGB_3.2x2.8_REVMOUNT_BACKWARDS

Connections:
/ledmatrix/LD1_CS1: LED1.1 (A), LED17.1 (A), LED33.1 (A), LED49.1 (A); also elsewhere on the board
/ledmatrix/LD1_CS2: LED2.1 (A), LED18.1 (A), LED34.1 (A), LED50.1 (A); also elsewhere on the board
/ledmatrix/LD1_CS3: LED3.1 (A), LED19.1 (A), LED35.1 (A), LED51.1 (A); also elsewhere on the board
/ledmatrix/LD1_CS4: LED4.1 (A), LED20.1 (A), LED36.1 (A), LED52.1 (A); also elsewhere on the board
/ledmatrix/LD1_CS5: LED5.1 (A), LED21.1 (A), LED37.1 (A), LED53.1 (A); also elsewhere on the board
/ledmatrix/LD1_CS6: LED6.1 (A), LED22.1 (A), LED38.1 (A), LED54.1 (A); also elsewhere on the board
/ledmatrix/LD1_CS7: LED7.1 (A), LED23.1 (A), LED39.1 (A), LED55.1 (A); also elsewhere on the board
/ledmatrix/LD1_CS8: LED8.1 (A), LED24.1 (A), LED40.1 (A), LED56.1 (A); also elsewhere on the board
/ledmatrix/LD1_CS9: LED9.1 (A), LED25.1 (A), LED41.1 (A), LED57.1 (A); also elsewhere on the board
/ledmatrix/LD1_CS10: LED10.1 (A), LED26.1 (A), LED42.1 (A), LED58.1 (A); also elsewhere on the board
/ledmatrix/LD1_CS11: LED11.1 (A), LED27.1 (A), LED43.1 (A), LED59.1 (A); also elsewhere on the board
/ledmatrix/LD1_CS12: LED12.1 (A), LED28.1 (A), LED44.1 (A), LED60.1 (A); also elsewhere on the board
/ledmatrix/LD1_CS13: LED13.1 (A), LED29.1 (A), LED45.1 (A), LED61.1 (A); also elsewhere on the board
/ledmatrix/LD1_CS14: LED14.1 (A), LED30.1 (A), LED46.1 (A), LED62.1 (A); also elsewhere on the board
/ledmatrix/LD1_CS15: LED15.1 (A), LED31.1 (A), LED47.1 (A), LED63.1 (A); also elsewhere on the board
/ledmatrix/LD1_CS16: LED16.1 (A), LED32.1 (A), LED48.1 (A), LED64.1 (A); also elsewhere on the board
/ledmatrix/LD1_SW1: LED1.3 (G), LED2.3 (G), LED3.3 (G), LED4.3 (G), LED5.3 (G), LED6.3 (G), LED7.3 (G), LED8.3 (G), LED9.3 (G), LED10.3 (G), LED11.3 (G), LED12.3 (G), LED13.3 (G), LED14.3 (G), LED15.3 (G), LED16.3 (G); also elsewhere on the board
/ledmatrix/LD1_SW2: LED1.2 (R), LED2.2 (R), LED3.2 (R), LED4.2 (R), LED5.2 (R), LED6.2 (R), LED7.2 (R), LED8.2 (R), LED9.2 (R), LED10.2 (R), LED11.2 (R), LED12.2 (R), LED13.2 (R), LED14.2 (R), LED15.2 (R), LED16.2 (R); also elsewhere on the board
/ledmatrix/LD1_SW3: LED1.4 (B), LED2.4 (B), LED3.4 (B), LED4.4 (B), LED5.4 (B), LED6.4 (B), LED7.4 (B), LED8.4 (B), LED9.4 (B), LED10.4 (B), LED11.4 (B), LED12.4 (B), LED13.4 (B), LED14.4 (B), LED15.4 (B), LED16.4 (B); also elsewhere on the board
/ledmatrix/LD1_SW4: LED17.3 (G), LED18.3 (G), LED19.3 (G), LED20.3 (G), LED21.3 (G), LED22.3 (G), LED23.3 (G), LED24.3 (G), LED25.3 (G), LED26.3 (G), LED27.3 (G), LED28.3 (G), LED29.3 (G), LED30.3 (G), LED31.3 (G), LED32.3 (G); also elsewhere on the board
/ledmatrix/LD1_SW5: LED17.2 (R), LED18.2 (R), LED19.2 (R), LED20.2 (R), LED21.2 (R), LED22.2 (R), LED23.2 (R), LED24.2 (R), LED25.2 (R), LED26.2 (R), LED27.2 (R), LED28.2 (R), LED29.2 (R), LED30.2 (R), LED31.2 (R), LED32.2 (R); also elsewhere on the board
/ledmatrix/LD1_SW6: LED17.4 (B), LED18.4 (B), LED19.4 (B), LED20.4 (B), LED21.4 (B), LED22.4 (B), LED23.4 (B), LED24.4 (B), LED25.4 (B), LED26.4 (B), LED27.4 (B), LED28.4 (B), LED29.4 (B), LED30.4 (B), LED31.4 (B), LED32.4 (B); also elsewhere on the board
/ledmatrix/LD1_SW7: LED33.3 (G), LED34.3 (G), LED35.3 (G), LED36.3 (G), LED37.3 (G), LED38.3 (G), LED39.3 (G), LED40.3 (G), LED41.3 (G), LED42.3 (G), LED43.3 (G), LED44.3 (G), LED45.3 (G), LED46.3 (G), LED47.3 (G), LED48.3 (G); also elsewhere on the board
/ledmatrix/LD1_SW8: LED33.2 (R), LED34.2 (R), LED35.2 (R), LED36.2 (R), LED37.2 (R), LED38.2 (R), LED39.2 (R), LED40.2 (R), LED41.2 (R), LED42.2 (R), LED43.2 (R), LED44.2 (R), LED45.2 (R), LED46.2 (R), LED47.2 (R), LED48.2 (R); also elsewhere on the board
/ledmatrix/LD1_SW9: LED33.4 (B), LED34.4 (B), LED35.4 (B), LED36.4 (B), LED37.4 (B), LED38.4 (B), LED39.4 (B), LED40.4 (B), LED41.4 (B), LED42.4 (B), LED43.4 (B), LED44.4 (B), LED45.4 (B), LED46.4 (B), LED47.4 (B), LED48.4 (B); also elsewhere on the board
/ledmatrix/LD1_SW10: LED49.3 (G), LED50.3 (G), LED51.3 (G), LED52.3 (G), LED53.3 (G), LED54.3 (G), LED55.3 (G), LED56.3 (G), LED57.3 (G), LED58.3 (G), LED59.3 (G), LED60.3 (G), LED61.3 (G), LED62.3 (G), LED63.3 (G), LED64.3 (G); also elsewhere on the board
/ledmatrix/LD1_SW11: LED49.2 (R), LED50.2 (R), LED51.2 (R), LED52.2 (R), LED53.2 (R), LED54.2 (R), LED55.2 (R), LED56.2 (R), LED57.2 (R), LED58.2 (R), LED59.2 (R), LED60.2 (R), LED61.2 (R), LED62.2 (R), LED63.2 (R), LED64.2 (R); also elsewhere on the board
/ledmatrix/LD1_SW12: LED49.4 (B), LED50.4 (B), LED51.4 (B), LED52.4 (B), LED53.4 (B), LED54.4 (B), LED55.4 (B), LED56.4 (B), LED57.4 (B), LED58.4 (B), LED59.4 (B), LED60.4 (B), LED61.4 (B), LED62.4 (B), LED63.4 (B), LED64.4 (B); also elsewhere on the board
/ledmatrix/LD2_CS1: LED65.1 (A), LED81.1 (A), LED97.1 (A), LED113.1 (A); also elsewhere on the board
/ledmatrix/LD2_CS2: LED66.1 (A), LED82.1 (A), LED98.1 (A), LED114.1 (A); also elsewhere on the board
/ledmatrix/LD2_CS3: LED67.1 (A), LED83.1 (A), LED99.1 (A), LED115.1 (A); also elsewhere on the board
/ledmatrix/LD2_CS4: LED68.1 (A), LED84.1 (A), LED100.1 (A), LED116.1 (A); also elsewhere on the board
/ledmatrix/LD2_CS5: LED69.1 (A), LED85.1 (A), LED101.1 (A), LED117.1 (A); also elsewhere on the board
/ledmatrix/LD2_CS6: LED70.1 (A), LED86.1 (A), LED102.1 (A), LED118.1 (A); also elsewhere on the board
/ledmatrix/LD2_CS7: LED71.1 (A), LED87.1 (A), LED103.1 (A), LED119.1 (A); also elsewhere on the board
/ledmatrix/LD2_CS8: LED72.1 (A), LED88.1 (A), LED104.1 (A); also elsewhere on the board
/ledmatrix/LD2_CS9: LED73.1 (A), LED89.1 (A), LED105.1 (A); also elsewhere on the board
/ledmatrix/LD2_CS10: LED74.1 (A), LED90.1 (A), LED106.1 (A); also elsewhere on the board
/ledmatrix/LD2_CS11: LED75.1 (A), LED91.1 (A), LED107.1 (A); also elsewhere on the board
/ledmatrix/LD2_CS12: LED76.1 (A), LED92.1 (A), LED108.1 (A); also elsewhere on the board
/ledmatrix/LD2_CS13: LED77.1 (A), LED93.1 (A), LED109.1 (A); also elsewhere on the board
/ledmatrix/LD2_CS14: LED78.1 (A), LED94.1 (A), LED110.1 (A); also elsewhere on the board
/ledmatrix/LD2_CS15: LED79.1 (A), LED95.1 (A), LED111.1 (A); also elsewhere on the board
/ledmatrix/LD2_CS16: LED80.1 (A), LED96.1 (A), LED112.1 (A); also elsewhere on the board
/ledmatrix/LD2_SW1: LED65.3 (G), LED66.3 (G), LED67.3 (G), LED68.3 (G), LED69.3 (G), LED70.3 (G), LED71.3 (G), LED72.3 (G), LED73.3 (G), LED74.3 (G), LED75.3 (G), LED76.3 (G), LED77.3 (G), LED78.3 (G), LED79.3 (G), LED80.3 (G); also elsewhere on the board
/ledmatrix/LD2_SW2: LED65.2 (R), LED66.2 (R), LED67.2 (R), LED68.2 (R), LED69.2 (R), LED70.2 (R), LED71.2 (R), LED72.2 (R), LED73.2 (R), LED74.2 (R), LED75.2 (R), LED76.2 (R), LED77.2 (R), LED78.2 (R), LED79.2 (R), LED80.2 (R); also elsewhere on the board
/ledmatrix/LD2_SW3: LED65.4 (B), LED66.4 (B), LED67.4 (B), LED68.4 (B), LED69.4 (B), LED70.4 (B), LED71.4 (B), LED72.4 (B), LED73.4 (B), LED74.4 (B), LED75.4 (B), LED76.4 (B), LED77.4 (B), LED78.4 (B), LED79.4 (B), LED80.4 (B); also elsewhere on the board
/ledmatrix/LD2_SW4: LED81.3 (G), LED82.3 (G), LED83.3 (G), LED84.3 (G), LED85.3 (G), LED86.3 (G), LED87.3 (G), LED88.3 (G), LED89.3 (G), LED90.3 (G), LED91.3 (G), LED92.3 (G), LED93.3 (G), LED94.3 (G), LED95.3 (G), LED96.3 (G); also elsewhere on the board
/ledmatrix/LD2_SW5: LED81.2 (R), LED82.2 (R), LED83.2 (R), LED84.2 (R), LED85.2 (R), LED86.2 (R), LED87.2 (R), LED88.2 (R), LED89.2 (R), LED90.2 (R), LED91.2 (R), LED92.2 (R), LED93.2 (R), LED94.2 (R), LED95.2 (R), LED96.2 (R); also elsewhere on the board
/ledmatrix/LD2_SW6: LED81.4 (B), LED82.4 (B), LED83.4 (B), LED84.4 (B), LED85.4 (B), LED86.4 (B), LED87.4 (B), LED88.4 (B), LED89.4 (B), LED90.4 (B), LED91.4 (B), LED92.4 (B), LED93.4 (B), LED94.4 (B), LED95.4 (B), LED96.4 (B); also elsewhere on the board
/ledmatrix/LD2_SW7: LED97.3 (G), LED98.3 (G), LED99.3 (G), LED100.3 (G), LED101.3 (G), LED102.3 (G), LED103.3 (G), LED104.3 (G), LED105.3 (G), LED106.3 (G), LED107.3 (G), LED108.3 (G), LED109.3 (G), LED110.3 (G), LED111.3 (G), LED112.3 (G); also elsewhere on the board
/ledmatrix/LD2_SW8: LED97.2 (R), LED98.2 (R), LED99.2 (R), LED100.2 (R), LED101.2 (R), LED102.2 (R), LED103.2 (R), LED104.2 (R), LED105.2 (R), LED106.2 (R), LED107.2 (R), LED108.2 (R), LED109.2 (R), LED110.2 (R), LED111.2 (R), LED112.2 (R); also elsewhere on the board
/ledmatrix/LD2_SW9: LED97.4 (B), LED98.4 (B), LED99.4 (B), LED100.4 (B), LED101.4 (B), LED102.4 (B), LED103.4 (B), LED104.4 (B), LED105.4 (B), LED106.4 (B), LED107.4 (B), LED108.4 (B), LED109.4 (B), LED110.4 (B), LED111.4 (B), LED112.4 (B); also elsewhere on the board
/ledmatrix/LD2_SW10: LED113.3 (G), LED114.3 (G), LED115.3 (G), LED116.3 (G), LED117.3 (G), LED118.3 (G), LED119.3 (G); also elsewhere on the board
/ledmatrix/LD2_SW11: LED113.2 (R), LED114.2 (R), LED115.2 (R), LED116.2 (R), LED117.2 (R), LED118.2 (R), LED119.2 (R); also elsewhere on the board
/ledmatrix/LD2_SW12: LED113.4 (B), LED114.4 (B), LED115.4 (B), LED116.4 (B), LED117.4 (B), LED118.4 (B), LED119.4 (B); also elsewhere on the board

Notes on the sheet:
Note: We remap the pins of the LED a bit for simplicity reasons: Datasheet: 1=G, 2=R, 3=B, 4=CA Remap in the footprint: 1=CA, 2=R, 3=G, 4=B

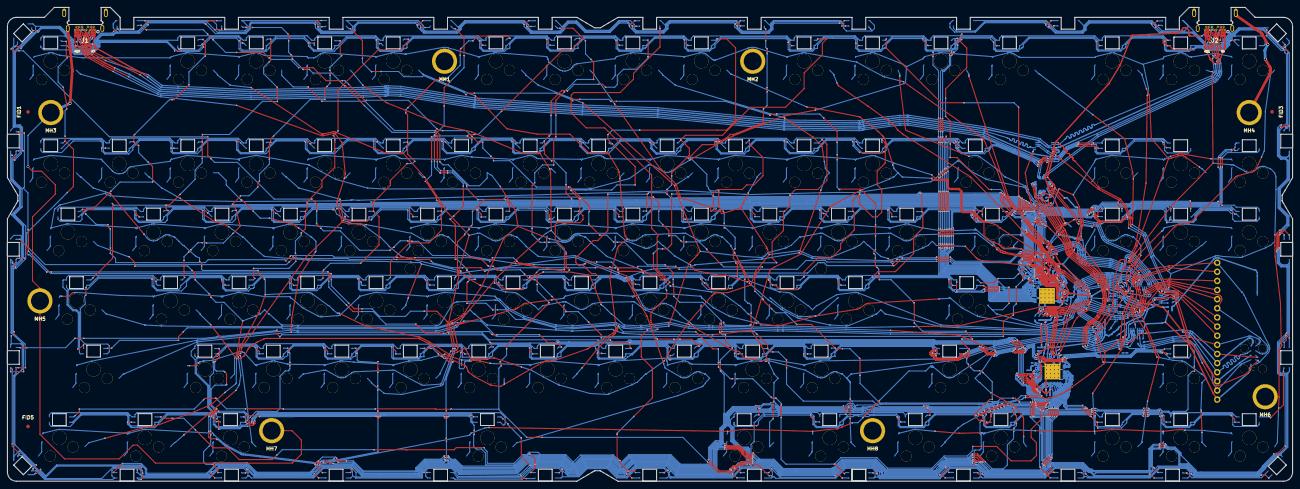
[picture p15: board K-Type.kicad_pcb from above]

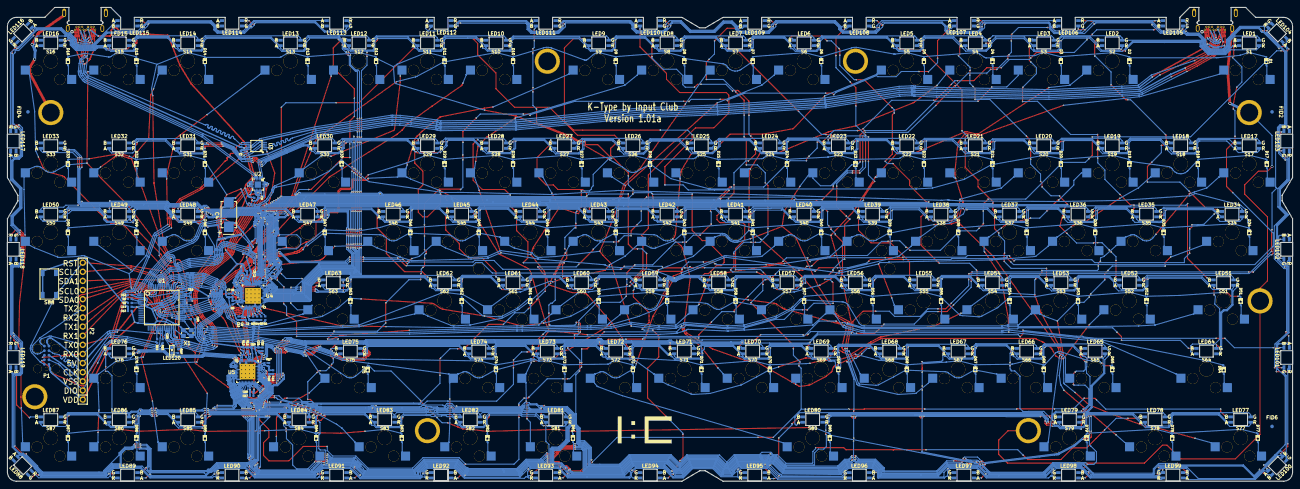
[picture p16: board K-Type.kicad_pcb from below]

Board: 2 copper layers, 357.5 x 131.8 mm, 362 parts (256 on the bottom side), 210 nets.

Other parts of the board:
FID1, FID2, FID3, FID4, FID5, FID6: >VALUE; FID
IC_LOGO: IC_LOGO
TH1, TH2: 1PAD; 1PAD-NPTH-SMALL
