cactode/k_type/(commit log)

2019-05-21 Changed footprints
2019-05-21 Updated footprints; everything is broken now.
2019-05-21 Removed bad traces; gotta redraw everything now
    [K-Type.kicad_pcb]
2019-05-25 Making slow, painful progress
    [K-Type.kicad_pcb]
2019-05-25 Making more, slow, painful progress
    [K-Type.kicad_pcb]
2019-05-25 Saving before more work
    [K-Type.kicad_pcb]
2019-05-25 Preparing to use autorouter?
    [K-Type.kicad_pcb]
2019-05-27 Adding newer attempt at PCB
    [K-Type PCBA BOM.xlsx, K-Type-2019-05-20-22-44-00.sch, K-Type-2019-05-27-02-45-36.sch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]
2019-05-27 Halfway done?
    [K-Type.kicad_pcb]
2019-05-27 Saving progress
    [K-Type.kicad_pcb]
2019-05-27 All RGB traces routed
    [K-Type.kicad_pcb]
2019-05-28 Finished routing interboard connections
    [K-Type.kicad_pcb]
2019-05-28 All traces except for cross traces routed
    [K-Type.kicad_pcb]
2019-05-28 Adding final cross traces
    [K-Type.kicad_pcb]
2019-05-28 add more traces
    [K-Type.kicad_pcb]
2019-05-30 Added some more traces
    [K-Type.kicad_pcb]
2019-06-02 Mechanical Stuff
    [K-Type.kicad_pcb, K-Type.sch, K-Type_original.kicad_pcb, SACRIFICIAL_BLOCK.DXF, k-type-case-.DXF, k-type-case-.SLDPRT, k-type-case-new_attempt.DXF, ledmatrix.sch]
2019-06-02 Fixing merge conflicts like a god
    [K-Type.kicad_pcb, K-Type.sch, K-Type_original.kicad_pcb, ledmatrix.sch, mcu.sch]
2019-06-02 About to do the dumb thing
    [K-Type.kicad_pcb]
